jcubillosg/Final_Project_RF/latex/images/noise_figure.png

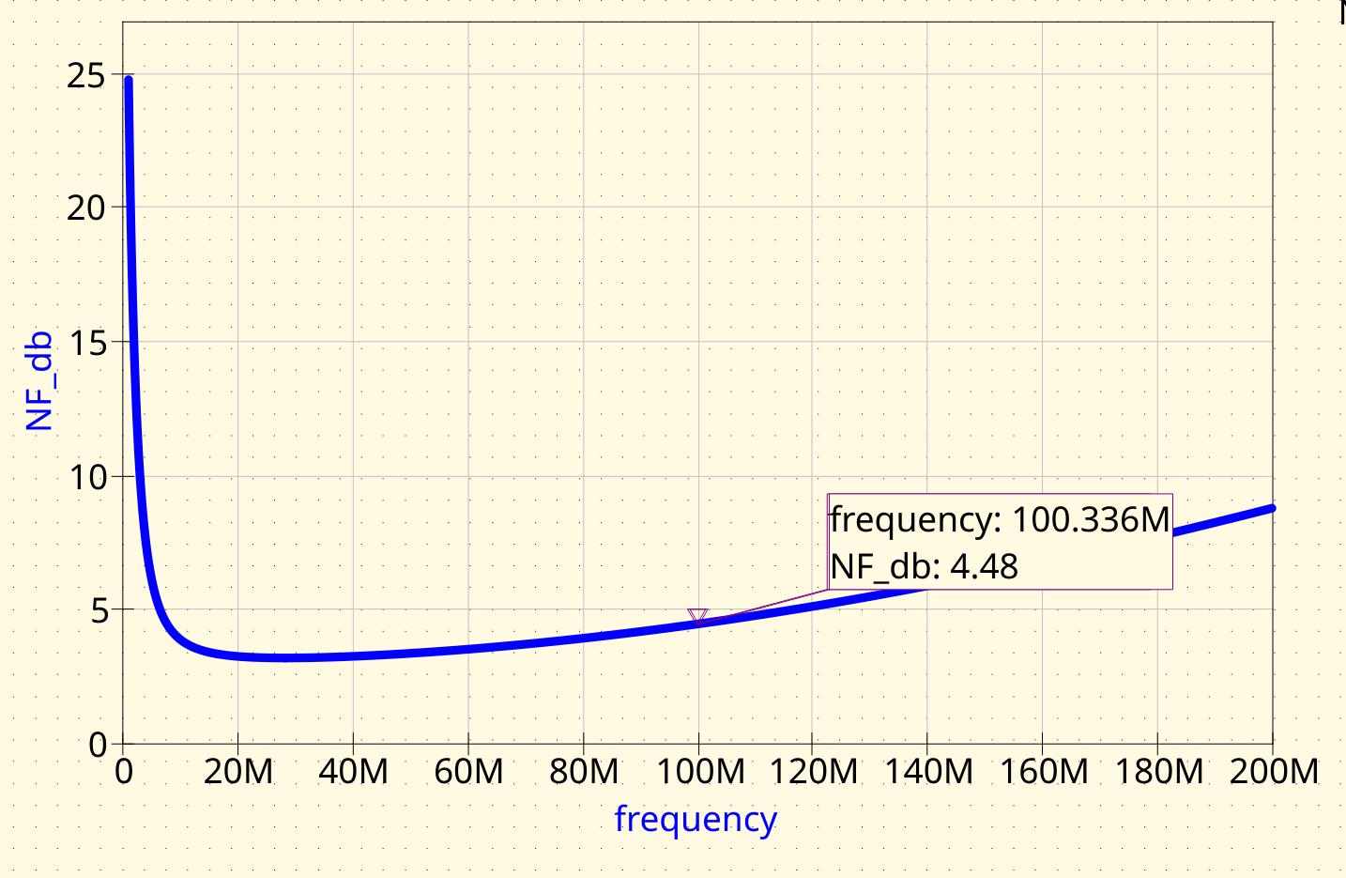
latex/images/noise_figure.png
