jcubillosg/Final_Project_RF/latex/images/s_11_matched.png

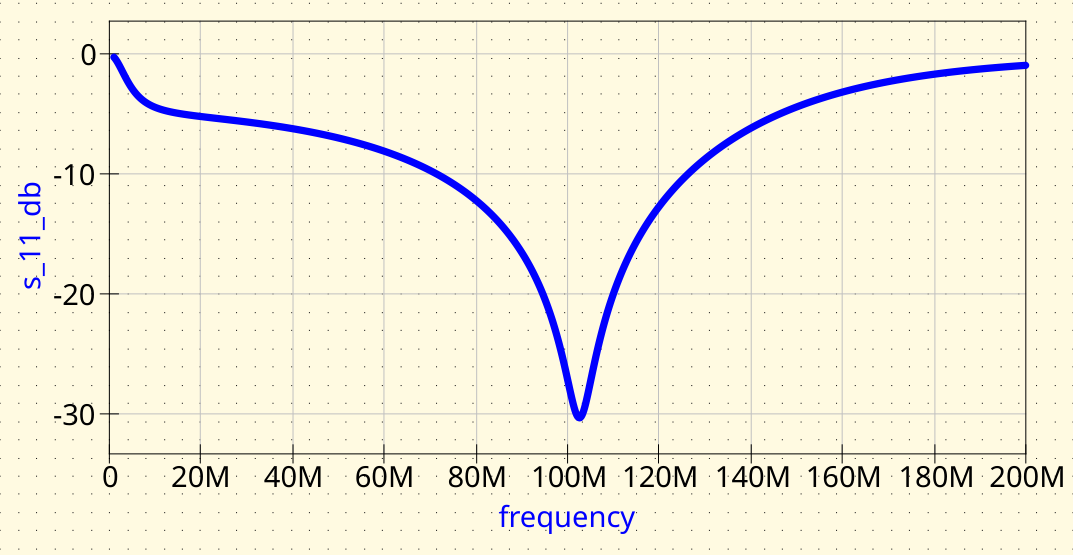
latex/images/s_11_matched.png
