jcubillosg/Final_Project_RF/latex/images/stability.png

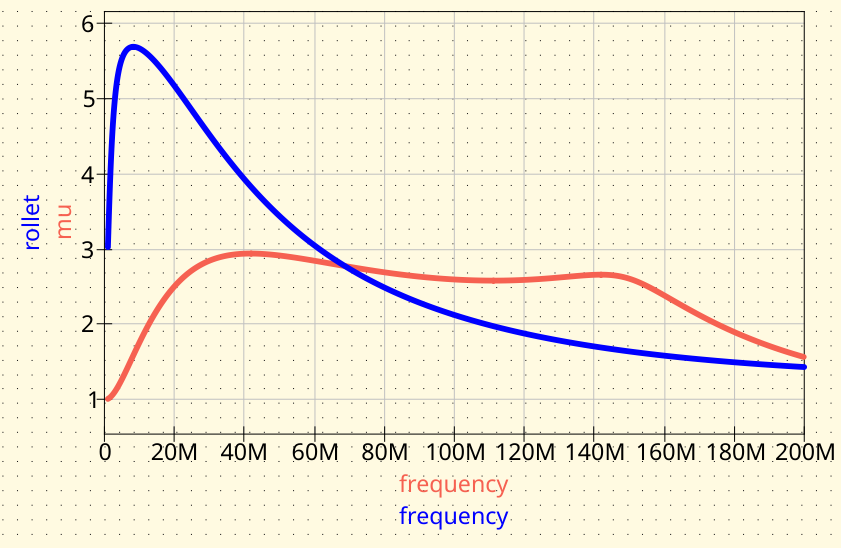
latex/images/stability.png
