jcubillosg/Final_Project_RF/pcb/LNA/LNA.kicad_pcb

## KiCad design pcb/LNA/LNA.kicad_pcb (2025-11-21)

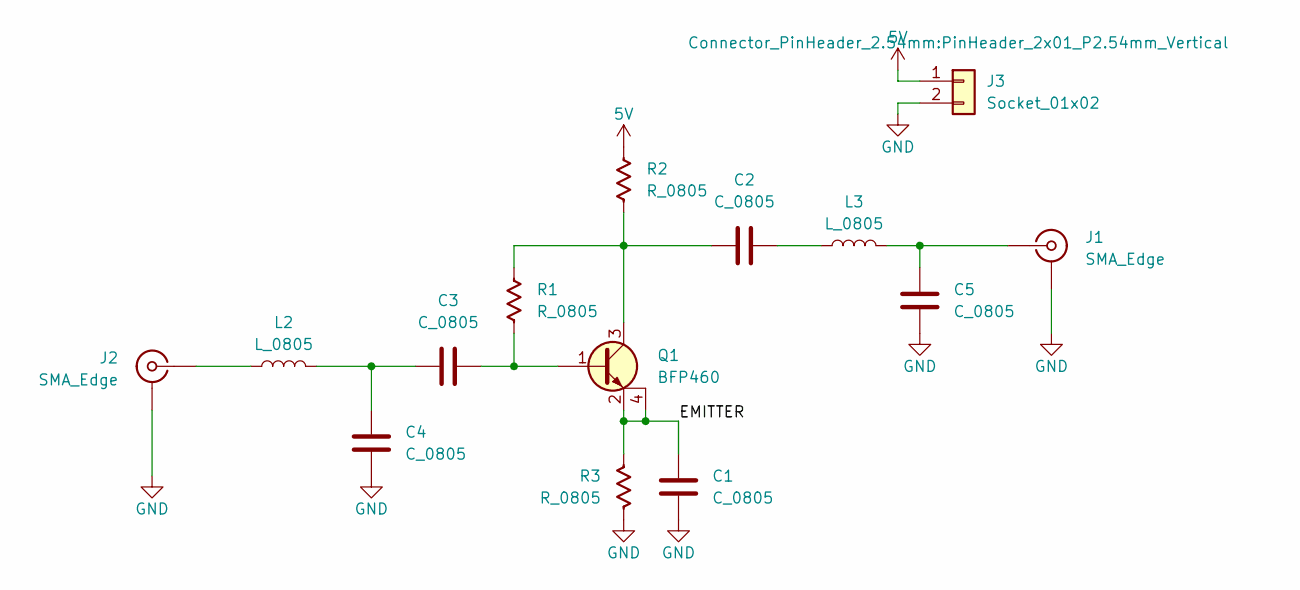
[picture p12: schematic LNA.kicad_sch]

Parts:
C1, C2, C3, C4, C5: C_0805; C_0805_2012Metric
J1, J2: SMA_Edge; SMA_Edge_8mm
J3: Socket_01x02; PinHeader_2x01_P2.54mm_Vertical; Part Number ?
L2, L3: L_0805; 0805
Q1: BFP460; SOT-343_SC-70-4
R1, R2, R3: R_0805; R_0805_2012Metric

Connections:
5V: J3.1, R2.1
/EMITTER: C1.1, Q1.2 (E), Q1.4 (E), R3.1
GND: C1.2, C4.2, C5.1, J1.2 (Ext), J2.2 (Ext), J3.2, R3.2
unnamed: C2.2, L3.1
unnamed: C3.1, C4.1, L2.2
unnamed: C5.2, J1.1 (In), L3.2
unnamed: J2.1 (In), L2.1
unnamed: C3.2, Q1.1 (B), R1.2
unnamed: C2.1, Q1.3 (C), R1.1, R2.2

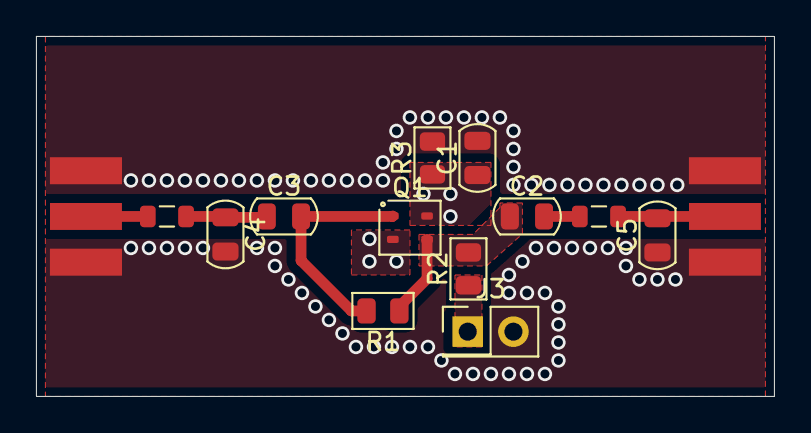
[picture p13: board LNA.kicad_pcb from above]

Board: 2 copper layers, 41.0 x 20.0 mm, 14 parts (0 on the bottom side), 9 nets.
