jcubillosg/Final_Project_RF/(commit log)

2025-10-31 First presentation
    [AC_Performance.sch, AC_transient_matched.sch, DC_Biasing.sch, LNA.kicad_pcb, LNA.kicad_sch, LNA_simulation.sch, LNA_simulation_s2p.sch, Stability_Gain_Noise.sch]
2025-11-09 Modified LNA schematics, added better comparison between s2p and SPICE models
    [LNA_simulation.sch, LNA_simulation_s2p.sch, Stability_Gain_Noise.sch]
2025-11-11 Added parameter circles, improved simulations
    [Stability_Gain_Noise.sch]
2025-11-21 Finished routing with 0805 components
    [LNA.kicad_pcb, LNA.kicad_sch, LNA_simulation.sch, LNA_simulation_s2p.sch, Stability_Gain_Noise.sch]
